GadgetReboot/555_Noise_Box/README.md

# 555_Noise_Box
Dual 555 oscillators with Flip Flop sub-oscillators controlled by MCP42100 digital pots to make sound effects or melodies
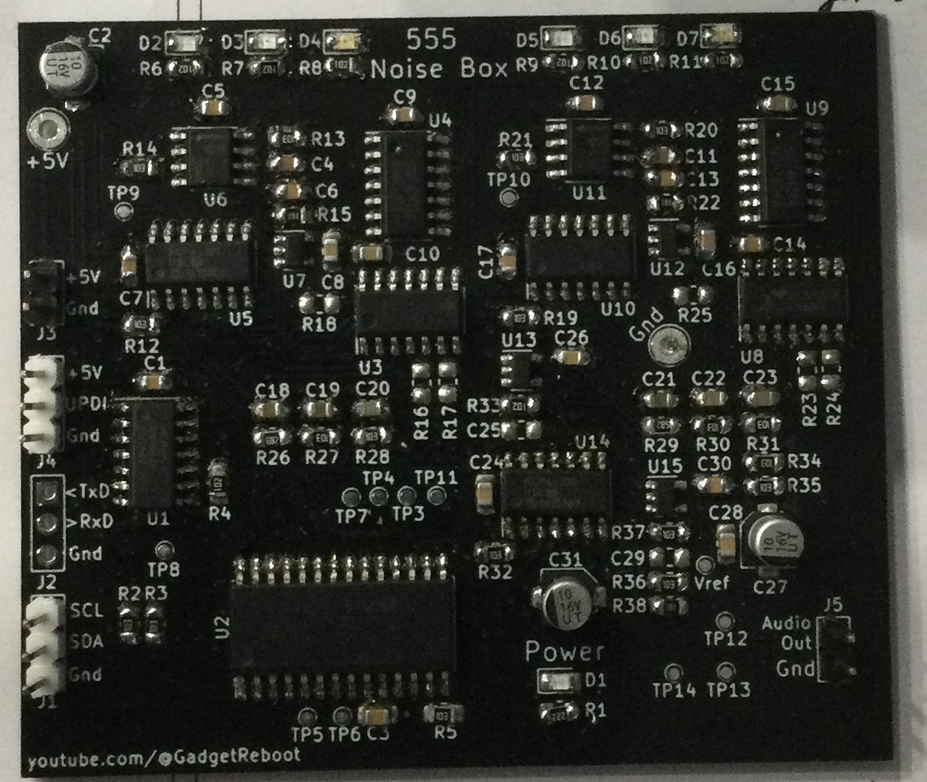
[picture p1: Assembled_PCB.jpg]
PCB
<br><br><BR><BR>
