GadgetReboot/555_Noise_Box/KiCad/SoundLogic-3D.png

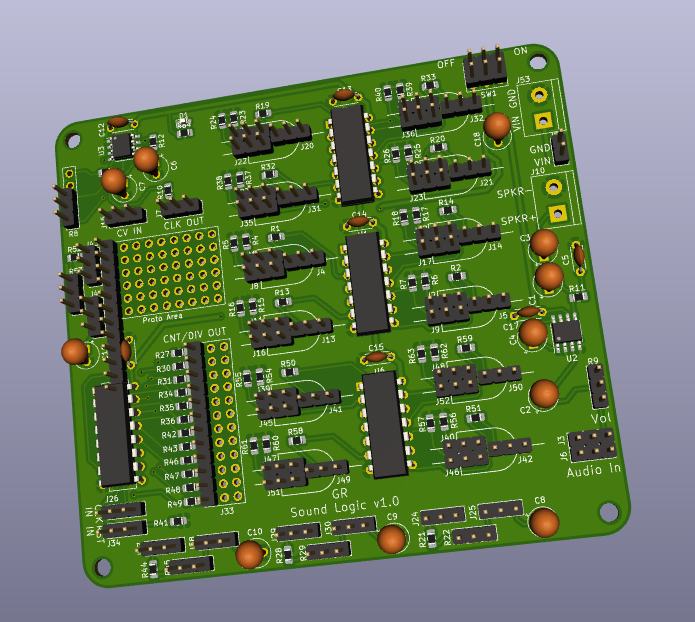
KiCad/SoundLogic-3D.png
