GadgetReboot/555_Noise_Box/Sch_555_Noise_Box.pdf

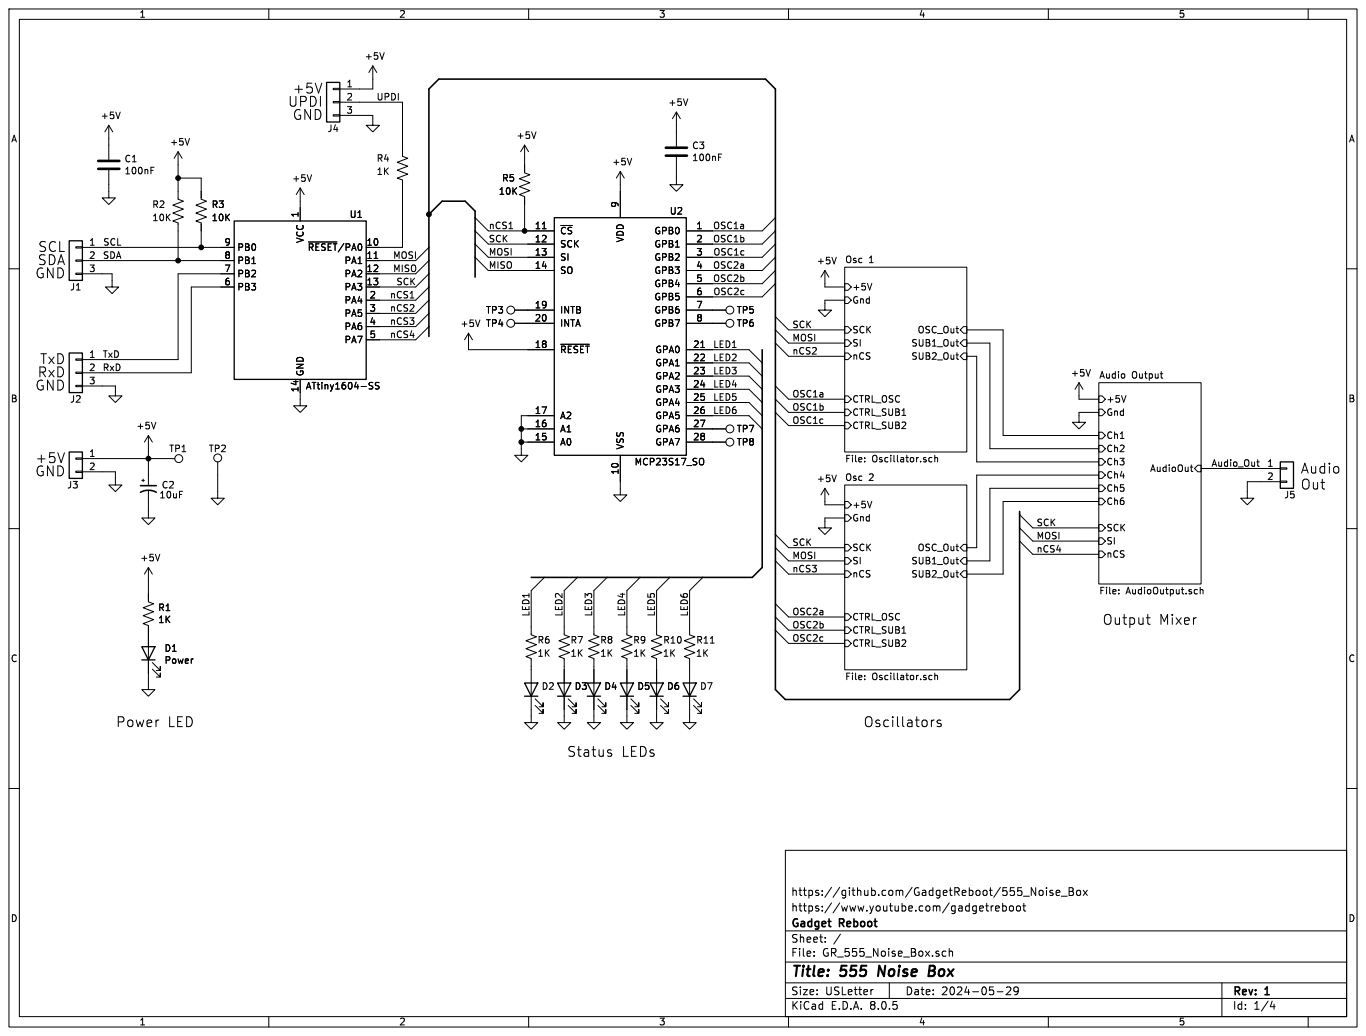
[picture p3: page 1]

Id: 1/4 Title: 555 Noise Box

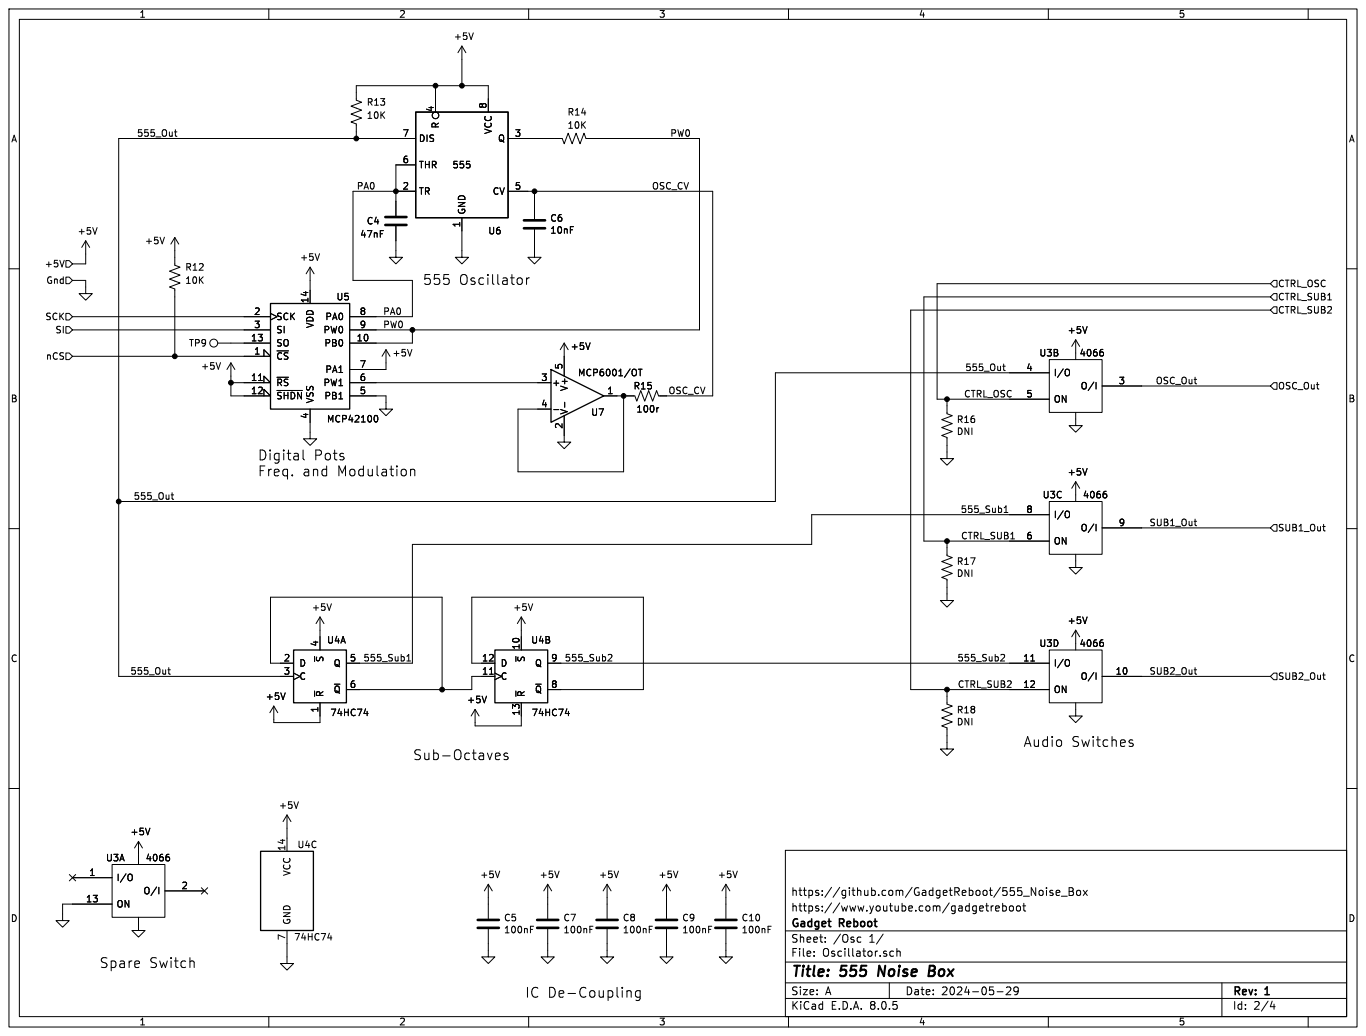
[picture p4: page 2]

https://github.com/GadgetReboot/555_Noise_Box

Id: 2/4 Title: 555 Noise Box

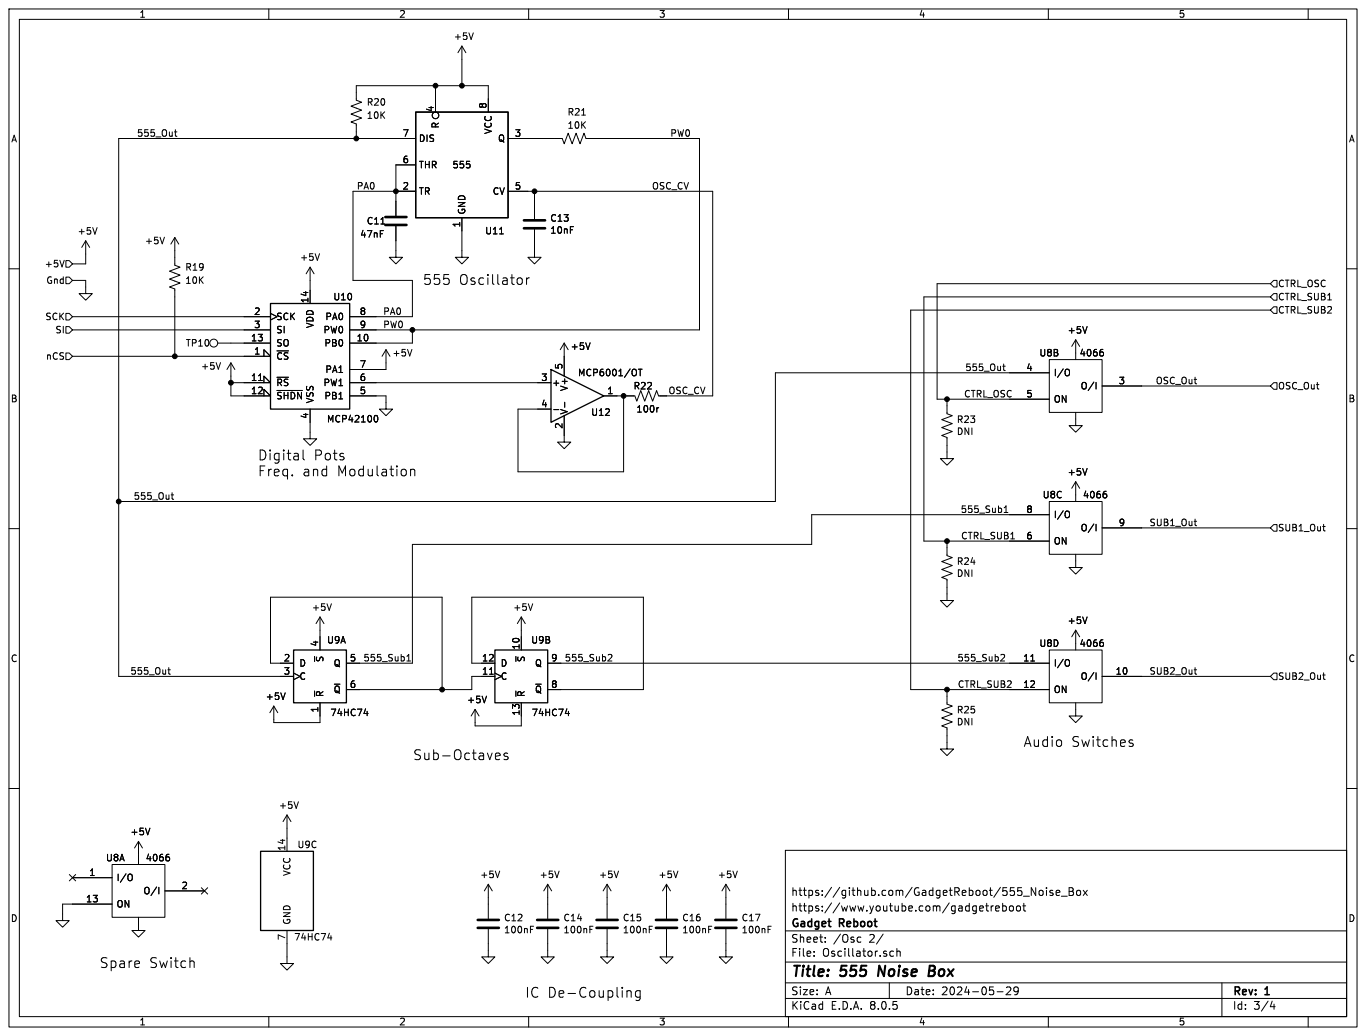
[picture p5: page 3]

https://github.com/GadgetReboot/555_Noise_Box

Id: 3/4 Title: 555 Noise Box

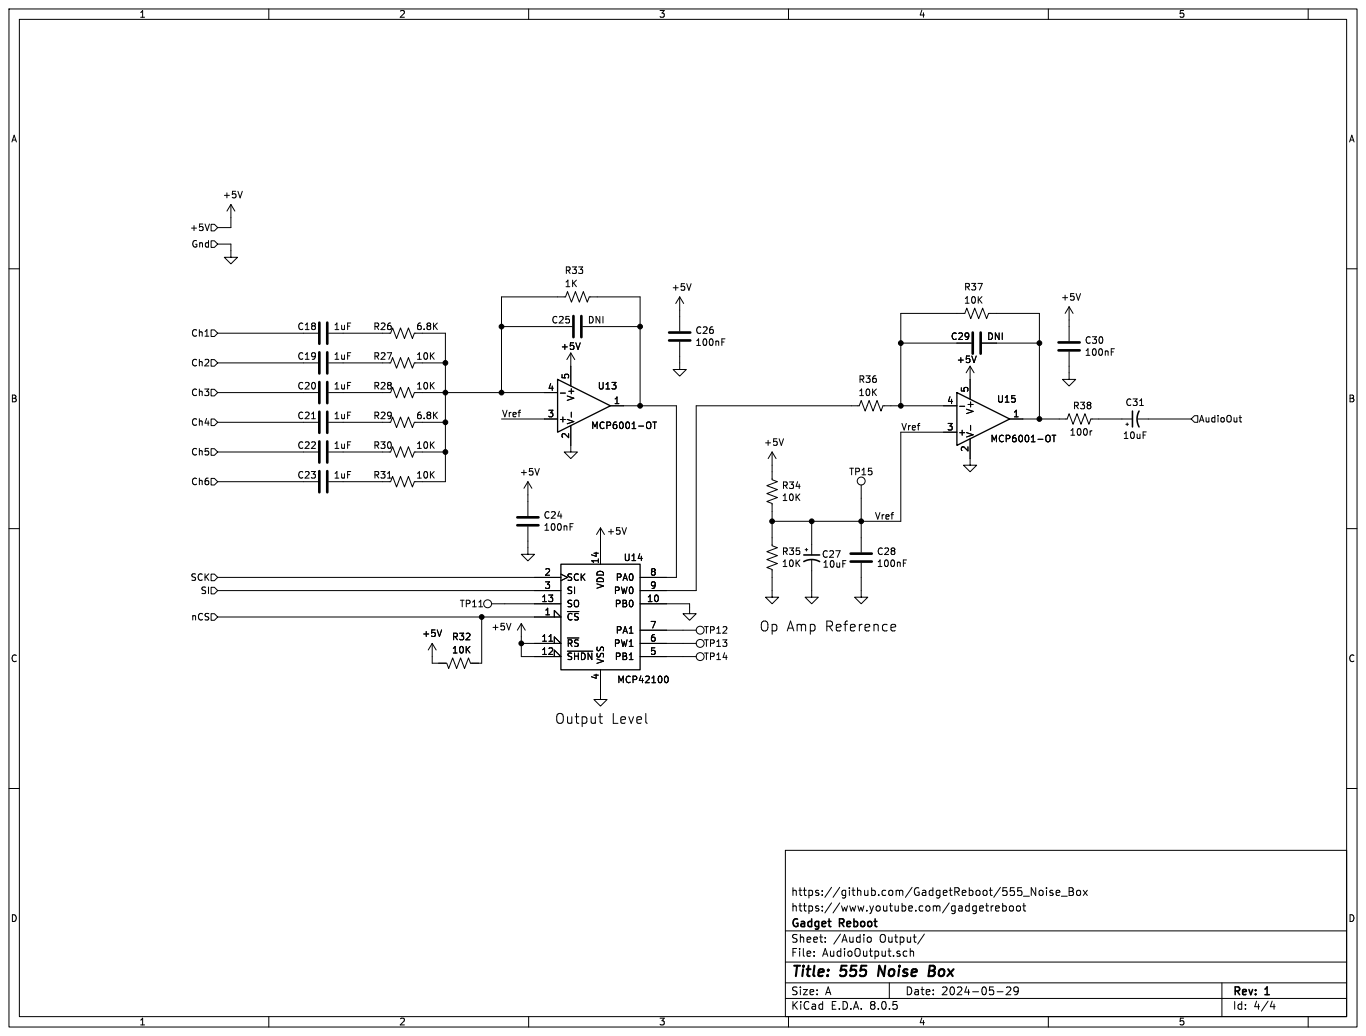
[picture p6: page 4]

Id: 4/4 Title: 555 Noise Box
