GadgetReboot/555_Noise_Box/KiCad/GR_555_Noise_Box.kicad_pcb

## KiCad design KiCad/GR_555_Noise_Box.kicad_pcb (2024-12-13)

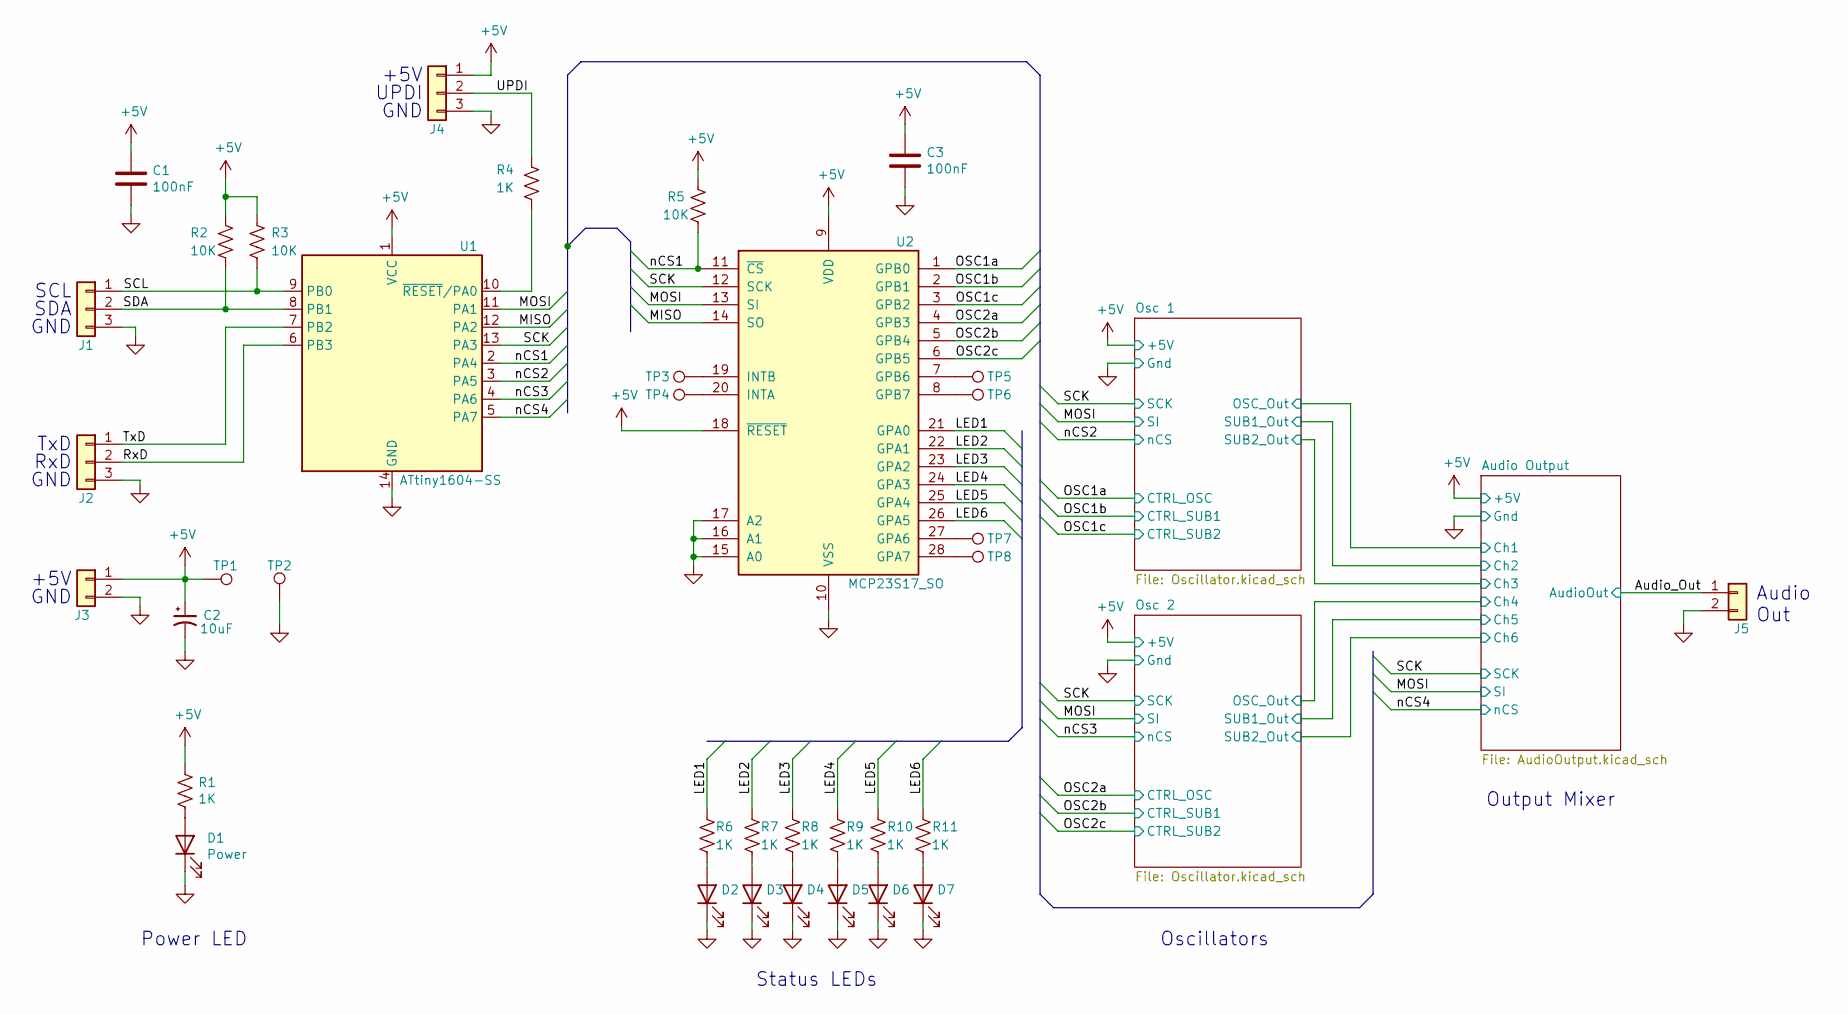
[picture p7: schematic GR_555_Noise_Box.kicad_sch, 555 Noise Box]

Parts:
C1, C3: 100nF; C_0805_2012Metric_Pad1.15x1.40mm_HandSolder
C2: 10uF; C_Elec_4x5.8
D1: Power; LED_0805_2012Metric_Pad1.15x1.40mm_HandSolder
D2, D3, D4, D5, D6, D7: LED; LED_0805_2012Metric_Pad1.15x1.40mm_HandSolder
J1, J2, J4: Conn_01x03; PinHeader_1x03_P2.54mm_Vertical_H1.0mm
J3, J5: 1x2; PinHeader_1x02_P2.54mm_Vertical_H1.0mm
R1, R4, R6, R7, R8, R9, R10, R11: 1K; R_0805_2012Metric_Pad1.15x1.40mm_HandSolder
R2, R3, R5: 10K; R_0805_2012Metric_Pad1.15x1.40mm_HandSolder
TP1, TP2: TestPoint; TestPoint_Loop_D2.54mm_Drill1.5mm_Beaded
TP3, TP4, TP5, TP6, TP7, TP8: TestPoint; TestPoint_Pad_D1.0mm
U1: ATtiny1604-SS; SOIC-14_3.9x8.7mm_P1.27mm
U2: MCP23S17_SO; SOIC-28W_7.5x17.9mm_P1.27mm

Connections:
+5V: C1.1, C2.1, C3.1, J3.1, J4.1, R1.1, R2.1, R3.1, R5.1, TP1.1, U1.1 (VCC), U2.9 (VDD), U2.18 (~RESET); also elsewhere on the board
/Audio_Out: J5.1; also elsewhere on the board
/LED1: R6.2, U2.21 (GPA0)
/LED2: R7.2, U2.22 (GPA1)
/LED3: R8.2, U2.23 (GPA2)
/LED4: R9.2, U2.24 (GPA3)
/LED5: R10.2, U2.25 (GPA4)
/LED6: R11.2, U2.26 (GPA5)
/MISO: U1.12 (PA2), U2.14 (SO)
/MOSI: U1.11 (PA1), U2.13 (SI); also elsewhere on the board
/OSC1a: U2.1 (GPB0); also elsewhere on the board
/OSC1b: U2.2 (GPB1); also elsewhere on the board
/OSC1c: U2.3 (GPB2); also elsewhere on the board
/OSC2a: U2.4 (GPB3); also elsewhere on the board
/OSC2b: U2.5 (GPB4); also elsewhere on the board
/OSC2c: U2.6 (GPB5); also elsewhere on the board
/RxD: J2.2, U1.6 (PB3)
/SCK: U1.13 (PA3), U2.12 (SCK); also elsewhere on the board
/SCL: J1.1, R3.2, U1.9 (PB0)
/SDA: J1.2, R2.2, U1.8 (PB1)
/TxD: J2.1, U1.7 (PB2)
/UPDI: J4.2, R4.1
/nCS1: R5.2, U1.2 (PA4), U2.11 (~CS)
/nCS2: U1.3 (PA5); also elsewhere on the board
/nCS3: U1.4 (PA6); also elsewhere on the board
/nCS4: U1.5 (PA7); also elsewhere on the board
GND: C1.2, C2.2, C3.2, D1.1 (K), D2.1 (K), D3.1 (K), D4.1 (K), D5.1 (K), D6.1 (K), D7.1 (K), J1.3, J2.3, J3.2, J4.3, J5.2, TP2.1, U1.14 (GND), U2.10 (VSS), U2.15 (A0), U2.16 (A1), U2.17 (A2); also elsewhere on the board
unnamed: D1.2 (A), R1.2
unnamed: D2.2 (A), R6.1
unnamed: D3.2 (A), R7.1
unnamed: D4.2 (A), R8.1
unnamed: D5.2 (A), R9.1
unnamed: D6.2 (A), R10.1
unnamed: D7.2 (A), R11.1
unnamed: R4.2, U1.10 (~RESET/PA0)
unnamed: TP3.1, U2.19 (INTB)
unnamed: TP4.1, U2.20 (INTA)
unnamed: TP5.1, U2.7 (GPB6)
unnamed: TP6.1, U2.8 (GPB7)
unnamed: TP7.1, U2.27 (GPA6)
unnamed: TP8.1, U2.28 (GPA7)

Notes on the sheet:
UPDI
GND
RxD
Output Mixer
+5V
SDA
Oscillators
Power LED
Status LEDs
TxD
Audio Out
SCL

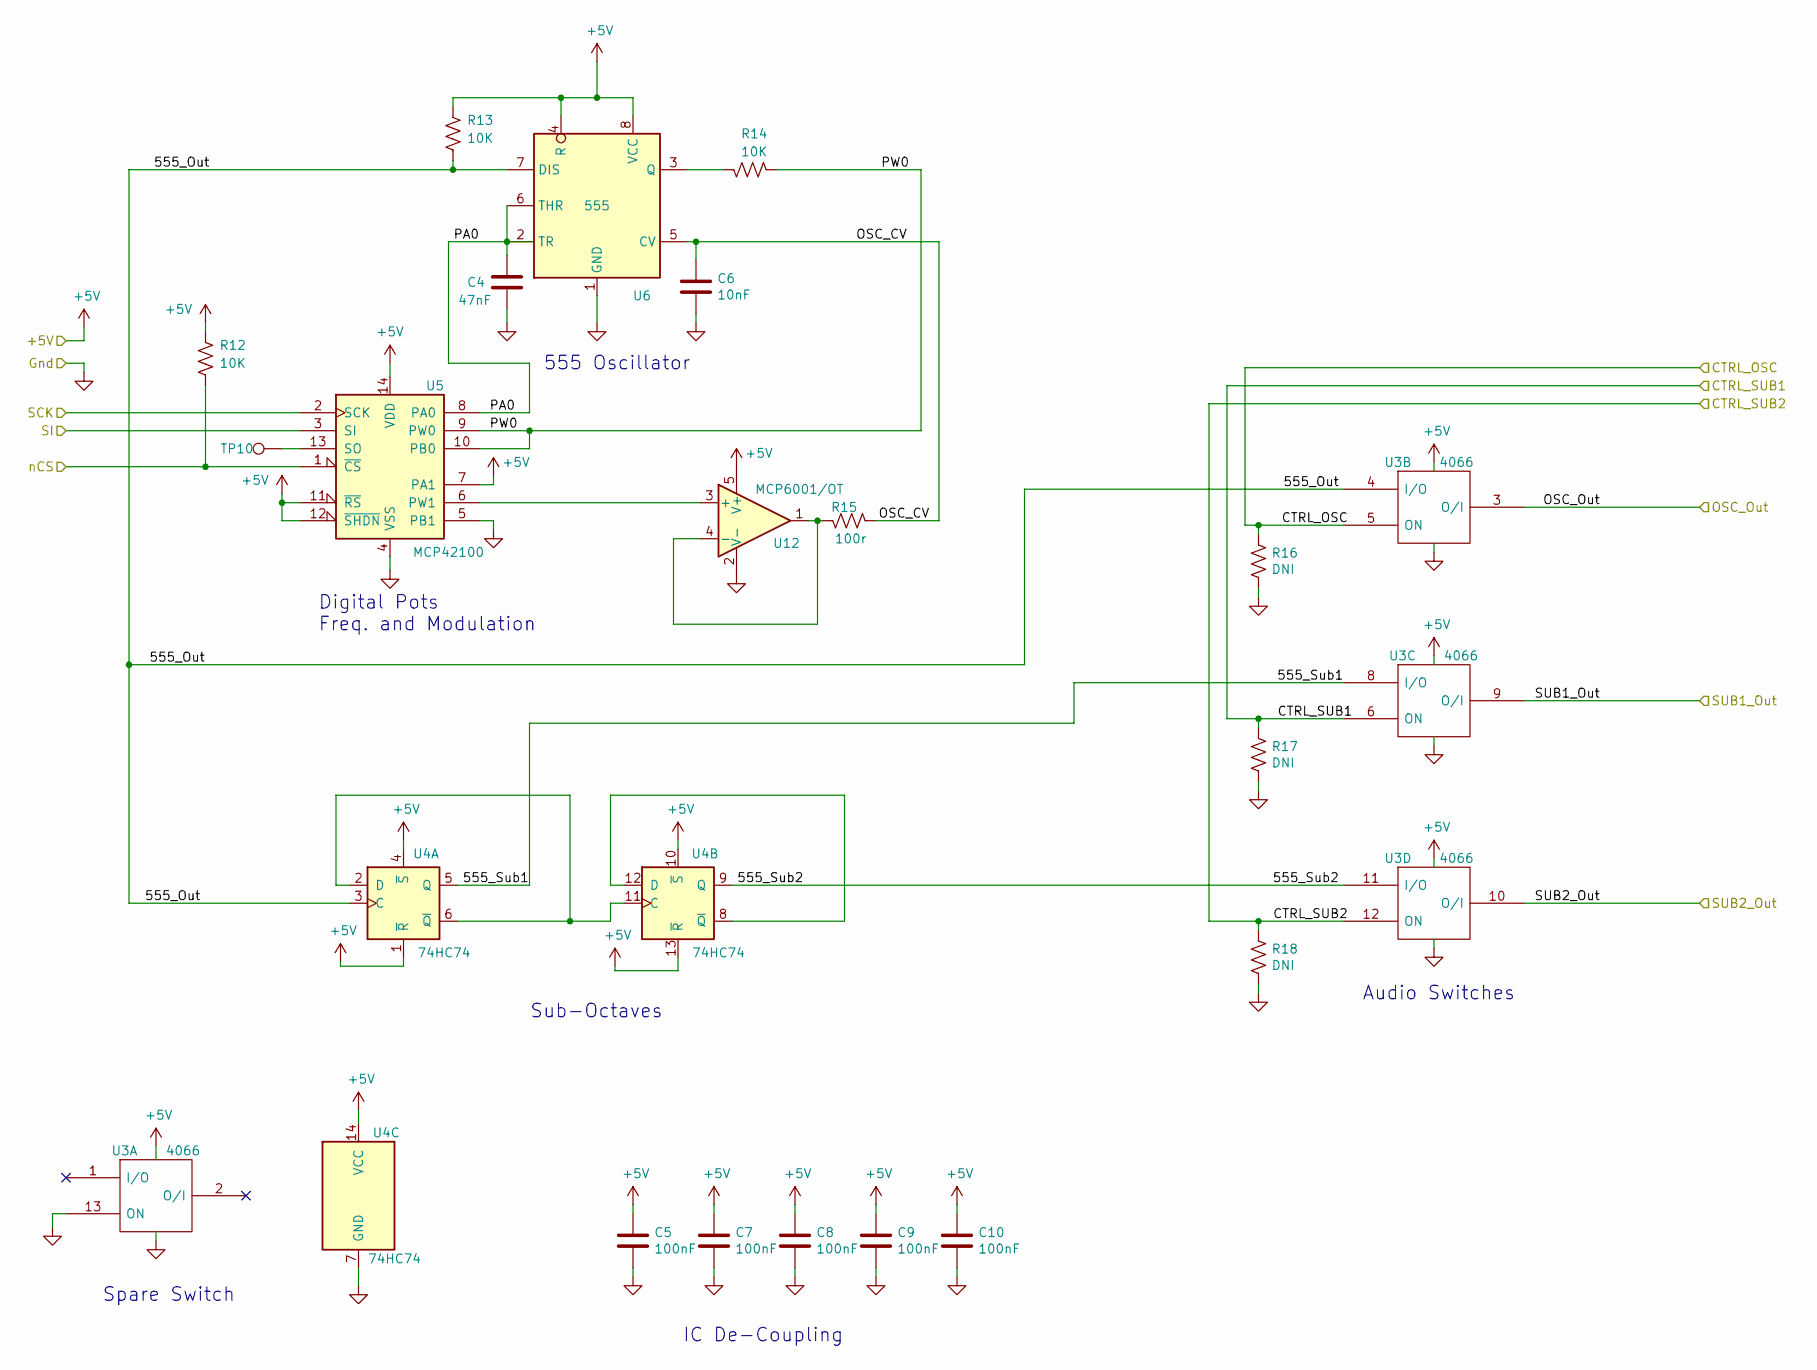
[picture p8: schematic Oscillator.kicad_sch, 555 Noise Box]

Parts:
C4: 47nF; C_0805_2012Metric_Pad1.15x1.40mm_HandSolder
C5, C7, C8, C9, C10: 100nF; C_0805_2012Metric_Pad1.15x1.40mm_HandSolder
C6: 10nF; C_0805_2012Metric_Pad1.15x1.40mm_HandSolder
R12, R13, R14: 10K; R_0805_2012Metric_Pad1.15x1.40mm_HandSolder
R15: 100r; R_0805_2012Metric_Pad1.15x1.40mm_HandSolder
R16, R17, R18: DNI; R_0805_2012Metric_Pad1.15x1.40mm_HandSolder
TP10: TestPoint; TestPoint_Pad_D1.0mm
U3: 4066; SOIC-14_3.9x8.7mm_P1.27mm
U4: 74HC74; SOIC-14_3.9x8.7mm_P1.27mm
U5: MCP42100; SOIC-14_3.9x8.7mm_P1.27mm
U6: 555; SOIC-8_3.9x4.9mm_P1.27mm
U12: MCP6001/OT; SOT-23-5

Connections:
+5V: C5.1, C7.1, C8.1, C9.1, C10.1, R12.1, R13.1, U3.14 (Vdd), U4.1 (~R), U4.4 (~S), U4.10 (~S), U4.13 (~R), U4.14 (VCC), U5.7 (PA1), U5.11 (~RS), U5.12 (~SHDN), U5.14 (VDD), U6.4 (R), U6.8 (VCC), U12.5 (V+); also elsewhere on the board
/Audio Output/Ch1: U3.3 (O/I); also elsewhere on the board
/Audio Output/Ch2: U3.9 (O/I); also elsewhere on the board
/Audio Output/Ch3: U3.10 (O/I); also elsewhere on the board
/MOSI: U5.3 (SI); also elsewhere on the board
/OSC1a: R16.1, U3.5 (ON); also elsewhere on the board
/OSC1b: R17.1, U3.6 (ON); also elsewhere on the board
/OSC1c: R18.1, U3.12 (ON); also elsewhere on the board
/Osc 1/555_Out: R13.2, U3.4 (I/O), U4.3 (C), U6.7 (DIS)
/Osc 1/555_Sub1: U3.8 (I/O), U4.5 (Q)
/Osc 1/555_Sub2: U3.11 (I/O), U4.9 (Q)
/Osc 1/OSC_CV: C6.1, R15.2, U6.5 (CV)
/Osc 1/PA0: C4.1, U5.8 (PA0), U6.2 (TR), U6.6 (THR)
/Osc 1/PW0: R14.2, U5.9 (PW0), U5.10 (PB0)
/SCK: U5.2 (SCK); also elsewhere on the board
/nCS2: R12.2, U5.1 (~CS); also elsewhere on the board
GND: C4.2, C5.2, C6.2, C7.2, C8.2, C9.2, C10.2, R16.2, R17.2, R18.2, U3.7 (Vss), U3.13 (ON), U4.7 (GND), U5.4 (VSS), U5.5 (PB1), U6.1 (GND), U12.2 (V-); also elsewhere on the board
unnamed: R14.1, U6.3 (Q)
unnamed: U4.2 (D), U4.6 (~Q), U4.11 (C)
unnamed: U4.8 (~Q), U4.12 (D)

Parts of its further copies:
C11: 47nF; C_0805_2012Metric_Pad1.15x1.40mm_HandSolder
C12, C14, C15, C16, C17: 100nF; C_0805_2012Metric_Pad1.15x1.40mm_HandSolder
C13: 10nF; C_0805_2012Metric_Pad1.15x1.40mm_HandSolder
R19, R20, R21: 10K; R_0805_2012Metric_Pad1.15x1.40mm_HandSolder
R22: 100r; R_0805_2012Metric_Pad1.15x1.40mm_HandSolder
R23, R24, R25: DNI; R_0805_2012Metric_Pad1.15x1.40mm_HandSolder
TP9: TestPoint; TestPoint_Pad_D1.0mm
U7: MCP6001/OT; SOT-23-5
U8: 4066; SOIC-14_3.9x8.7mm_P1.27mm
U9: 74HC74; SOIC-14_3.9x8.7mm_P1.27mm
U10: MCP42100; SOIC-14_3.9x8.7mm_P1.27mm
U11: 555; SOIC-8_3.9x4.9mm_P1.27mm

Connections of its further copies:
+5V: C12.1, C14.1, C15.1, C16.1, C17.1, R19.1, R20.1, U7.5 (V+), U8.14 (Vdd), U9.1 (~R), U9.4 (~S), U9.10 (~S), U9.13 (~R), U9.14 (VCC), U10.7 (PA1), U10.11 (~RS), U10.12 (~SHDN), U10.14 (VDD), U11.4 (R), U11.8 (VCC); also elsewhere on the board
/Audio Output/Ch4: U8.3 (O/I); also elsewhere on the board
/Audio Output/Ch5: U8.9 (O/I); also elsewhere on the board
/Audio Output/Ch6: U8.10 (O/I); also elsewhere on the board
/MOSI: U10.3 (SI); also elsewhere on the board
/OSC2a: R23.1, U8.5 (ON); also elsewhere on the board
/OSC2b: R24.1, U8.6 (ON); also elsewhere on the board
/OSC2c: R25.1, U8.12 (ON); also elsewhere on the board
/Osc 2/555_Out: R20.2, U8.4 (I/O), U9.3 (C), U11.7 (DIS)
/Osc 2/555_Sub1: U8.8 (I/O), U9.5 (Q)
/Osc 2/555_Sub2: U8.11 (I/O), U9.9 (Q)
/Osc 2/OSC_CV: C13.1, R22.2, U11.5 (CV)
/Osc 2/PA0: C11.1, U10.8 (PA0), U11.2 (TR), U11.6 (THR)
/Osc 2/PW0: R21.2, U10.9 (PW0), U10.10 (PB0)
/SCK: U10.2 (SCK); also elsewhere on the board
/nCS3: R19.2, U10.1 (~CS); also elsewhere on the board
GND: C11.2, C12.2, C13.2, C14.2, C15.2, C16.2, C17.2, R23.2, R24.2, R25.2, U7.2 (V-), U8.7 (Vss), U8.13 (ON), U9.7 (GND), U10.4 (VSS), U10.5 (PB1), U11.1 (GND); also elsewhere on the board
unnamed: R21.1, U11.3 (Q)
unnamed: U9.2 (D), U9.6 (~Q), U9.11 (C)
unnamed: U9.8 (~Q), U9.12 (D)

Notes on the sheet:
Audio Switches
Sub-Octaves
Spare Switch
555 Oscillator
Digital Pots Freq. and Modulation
IC De-Coupling

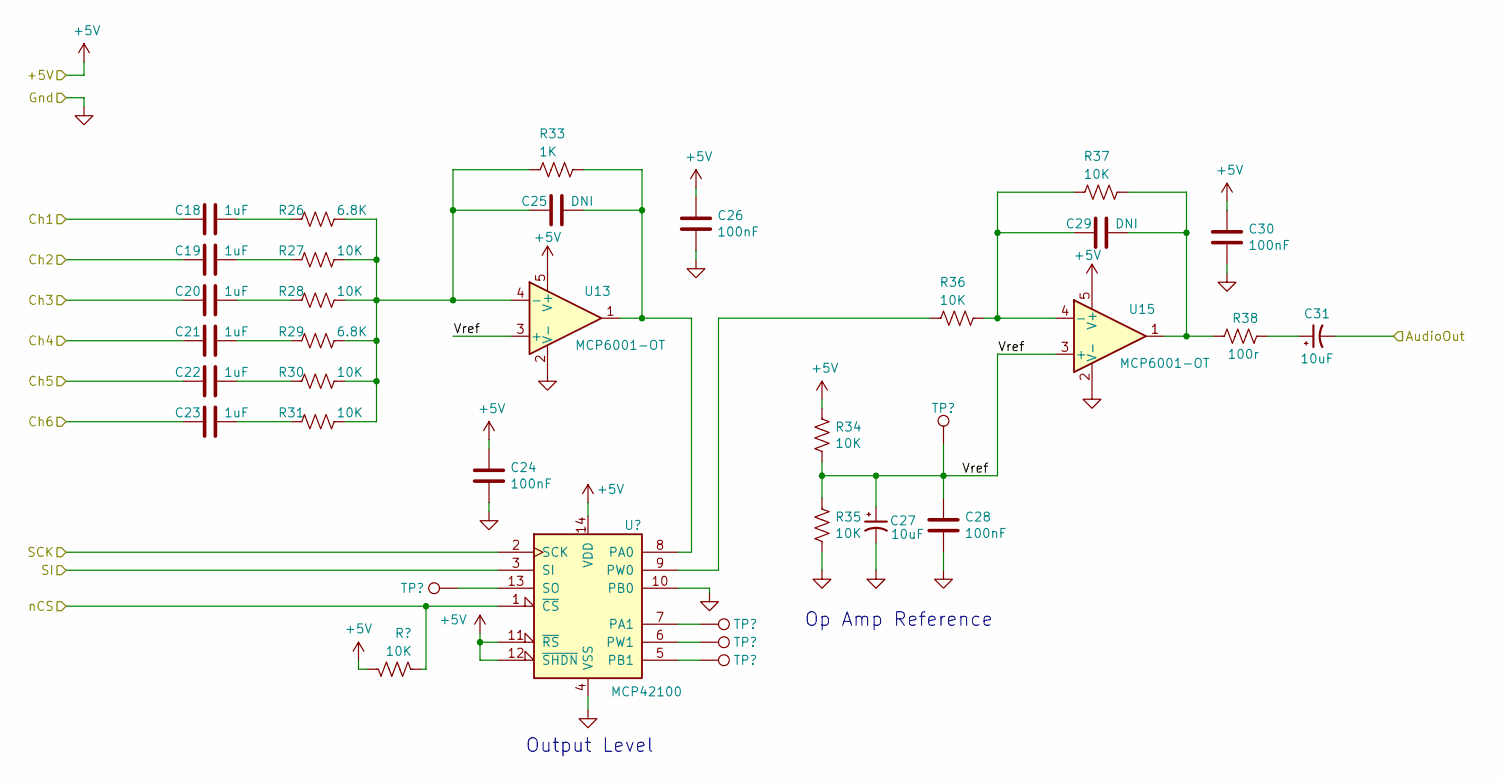
[picture p9: schematic AudioOutput.kicad_sch, 555 Noise Box]

Parts:
C18, C19, C20, C21, C22, C23: 1uF; C_0805_2012Metric_Pad1.15x1.40mm_HandSolder
C24, C26, C28, C30: 100nF; C_0805_2012Metric_Pad1.15x1.40mm_HandSolder
C25, C29: DNI; C_0805_2012Metric_Pad1.15x1.40mm_HandSolder
C27, C31: 10uF; C_Elec_4x5.8
R26, R29: 6.8K; R_0805_2012Metric_Pad1.15x1.40mm_HandSolder
R27, R28, R30, R31, R32, R34, R35, R36, R37: 10K; R_0805_2012Metric_Pad1.15x1.40mm_HandSolder
R33: 1K; R_0805_2012Metric_Pad1.15x1.40mm_HandSolder
R38: 100r; R_0805_2012Metric_Pad1.15x1.40mm_HandSolder
TP11, TP12, TP13, TP14, TP15: TestPoint; TestPoint_Pad_D1.0mm
U13, U15: MCP6001-OT; SOT-23-5
U14: MCP42100; SOIC-14_3.9x8.7mm_P1.27mm

Connections:
+5V: C24.1, C26.1, C30.1, R32.1, R34.1, U13.5 (V+), U14.11 (~RS), U14.12 (~SHDN), U14.14 (VDD), U15.5 (V+); also elsewhere on the board
/Audio Output/Ch1: C18.2; also elsewhere on the board
/Audio Output/Ch2: C19.2; also elsewhere on the board
/Audio Output/Ch3: C20.2; also elsewhere on the board
/Audio Output/Ch4: C21.2; also elsewhere on the board
/Audio Output/Ch5: C22.2; also elsewhere on the board
/Audio Output/Ch6: C23.2; also elsewhere on the board
/Audio Output/Vref: C27.1, C28.1, R34.2, R35.1, TP15.1, U13.3 (+), U15.3 (+)
/Audio_Out: C31.2; also elsewhere on the board
/MOSI: U14.3 (SI); also elsewhere on the board
/SCK: U14.2 (SCK); also elsewhere on the board
/nCS4: R32.2, U14.1 (~CS); also elsewhere on the board
GND: C24.2, C26.2, C27.2, C28.2, C30.2, R35.2, U13.2 (V-), U14.4 (VSS), U14.10 (PB0), U15.2 (V-); also elsewhere on the board
unnamed: C18.1, R26.2
unnamed: C19.1, R27.2
unnamed: C20.1, R28.2
unnamed: C21.1, R29.2
unnamed: C22.1, R30.2
unnamed: C23.1, R31.2
unnamed: C25.1, R33.1, U13.1, U14.8 (PA0)
unnamed: C25.2, R26.1, R27.1, R28.1, R29.1, R30.1, R31.1, R33.2, U13.4 (-)
unnamed: C29.1, R37.1, R38.2, U15.1
unnamed: C29.2, R36.1, R37.2, U15.4 (-)
unnamed: C31.1, R38.1
unnamed: R36.2, U14.9 (PW0)
unnamed: TP11.1, U14.13 (SO)
unnamed: TP12.1, U14.7 (PA1)
unnamed: TP13.1, U14.6 (PW1)
unnamed: TP14.1, U14.5 (PB1)

Notes on the sheet:
Output Level
Op Amp Reference

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
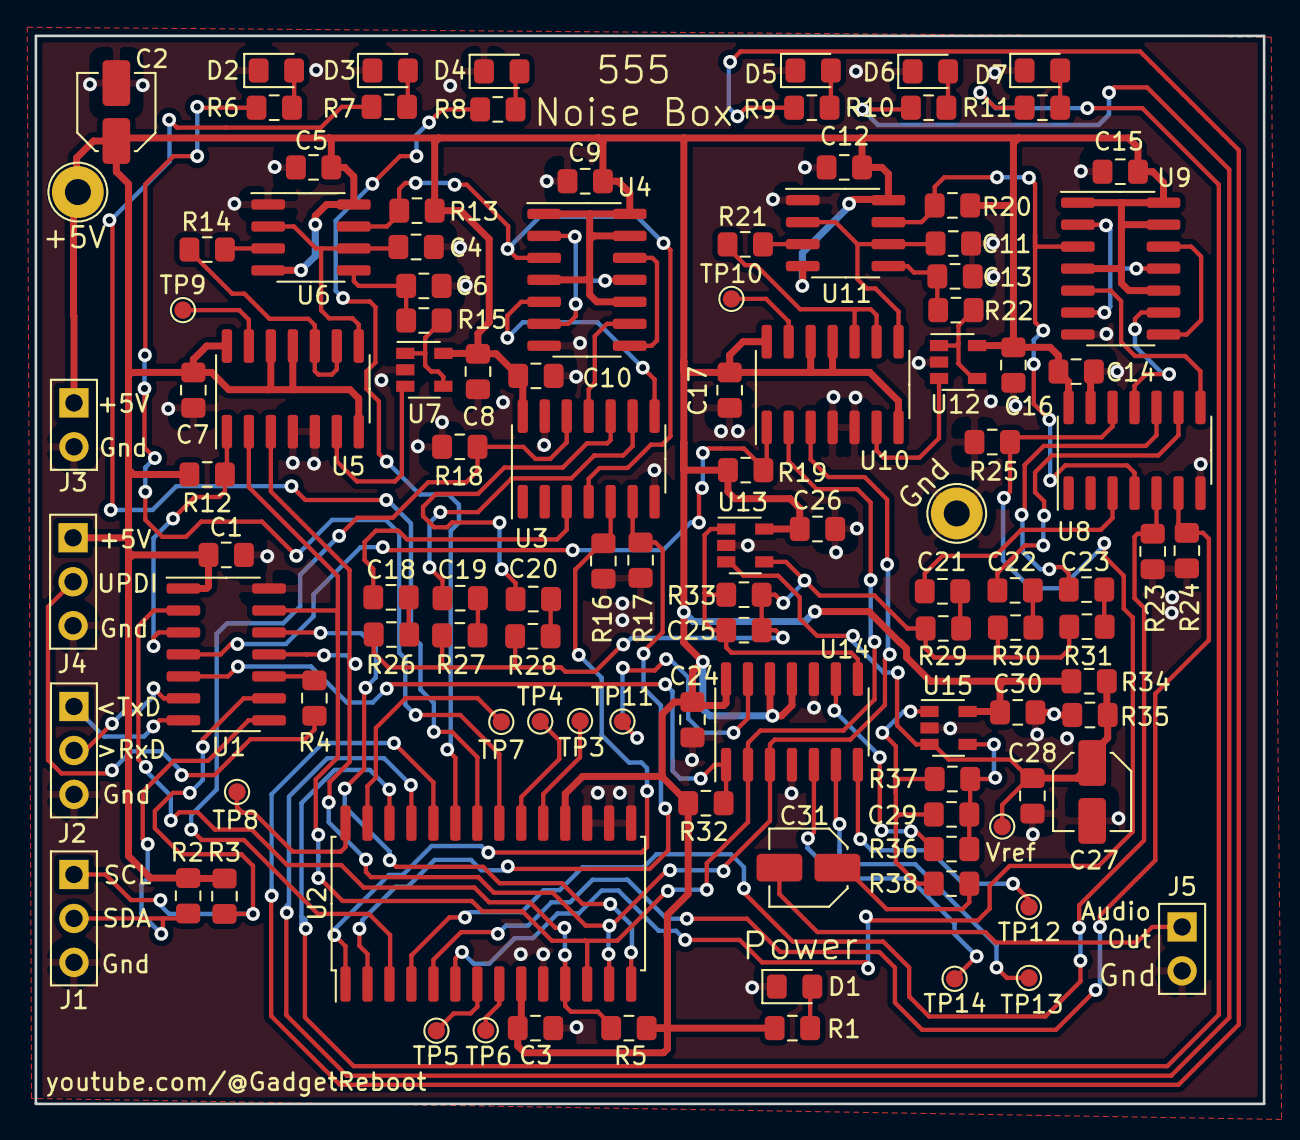
[picture p10: board GR_555_Noise_Box.kicad_pcb from above]

Board: 2 copper layers, 71.0 x 61.7 mm, 111 parts (0 on the bottom side), 88 nets.
